harshkp20/FingerPrint-Based-Door-Lock/README.md

# FingerPrint-Based-Door-Lock
This was a project developed under the course EE381-Electrical Engineering Laboratory II
